HDEmerald/waveform_viewer/README.md

# waveform_viewer
A guitar pedal whose sole purpose is to display the guitar's signal onto a display.
