HDEmerald/waveform_viewer/models/pedal_spacer v4.3mf

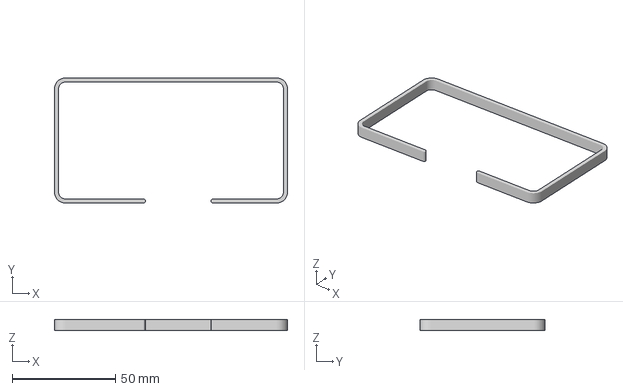
[picture p1: CAD file, 2024-09-13]
models/pedal_spacer v4.3mf
112.8 x 60.5 x 5.50 mm
