HDEmerald/waveform_viewer/models/pedal_spacer v1.3mf

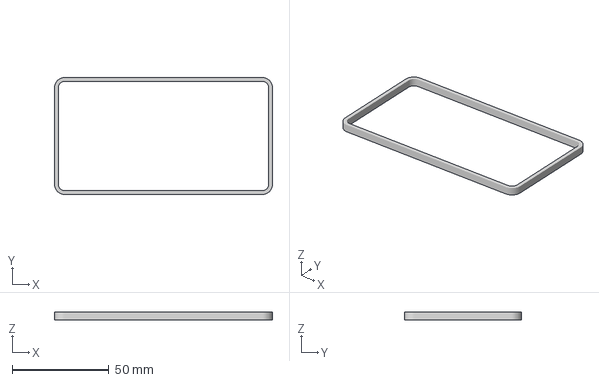
[picture p2: CAD file, 2024-09-13, an earlier design]
models/pedal_spacer v1.3mf
112.8 x 60.5 x 4.00 mm
