HDEmerald/waveform_viewer/models/pedal_spacer v3.3mf

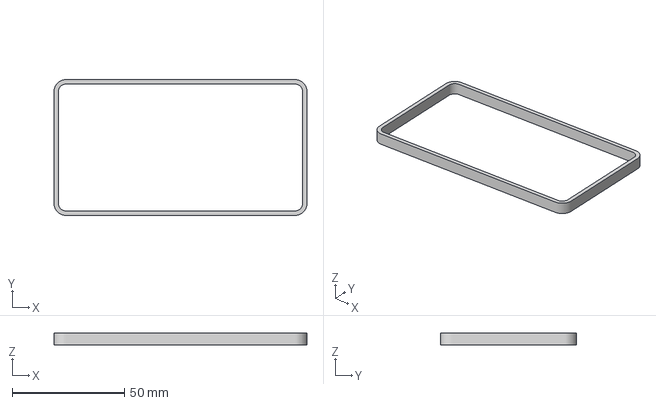
[picture p3: CAD file, 2024-09-13, an earlier design]
models/pedal_spacer v3.3mf
112.8 x 60.5 x 5.50 mm
