HDEmerald/waveform_viewer/models/pedal_spacer v2.3mf

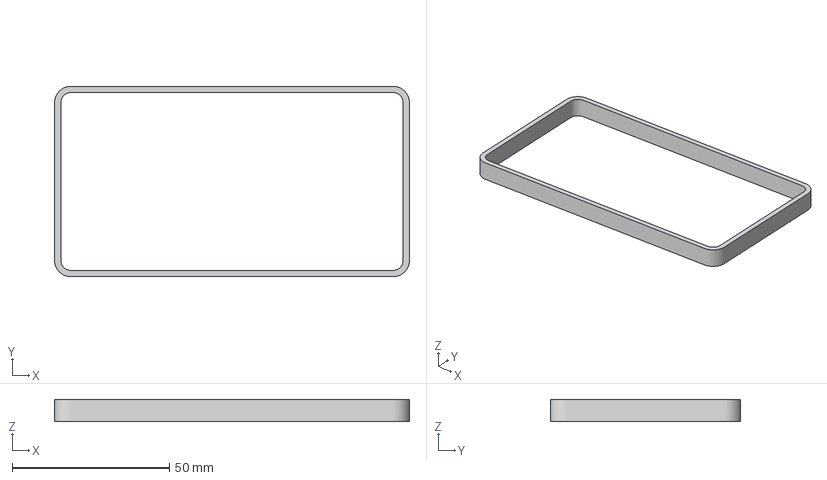
[picture p4: CAD file, 2024-09-13, an earlier design]
models/pedal_spacer v2.3mf
112.8 x 60.5 x 7.00 mm
