HDEmerald/waveform_viewer/sim/guitar_waveform_clamp_sim.asc

D1: diode; 1N4148
Q1: npn; 2N3904
Q2: pnp; 2N3906
R1: res; 1k
R2: res; 8.2k
R3: res; 100k
V1: voltage; 3.3
V2: voltage; 1
Named nets: 0, Vout, Vin
.dc V2 -1 5 .1
Hunter Drake
OLED Guitar Pedal Project (clamp stage)
7/9/2024
 
Creates a 3.3V ADC friendly signal at Vout.
Vin should not go below -0.5V or above 4V to be safe
 
NEEDS TO BE TEST IRL PLEASE TEST MF
