HDEmerald/waveform_viewer/pcb/Guitar_waveform_proj.kicad_pcb

## KiCad design pcb/Guitar_waveform_proj.kicad_pcb (2024-09-13)

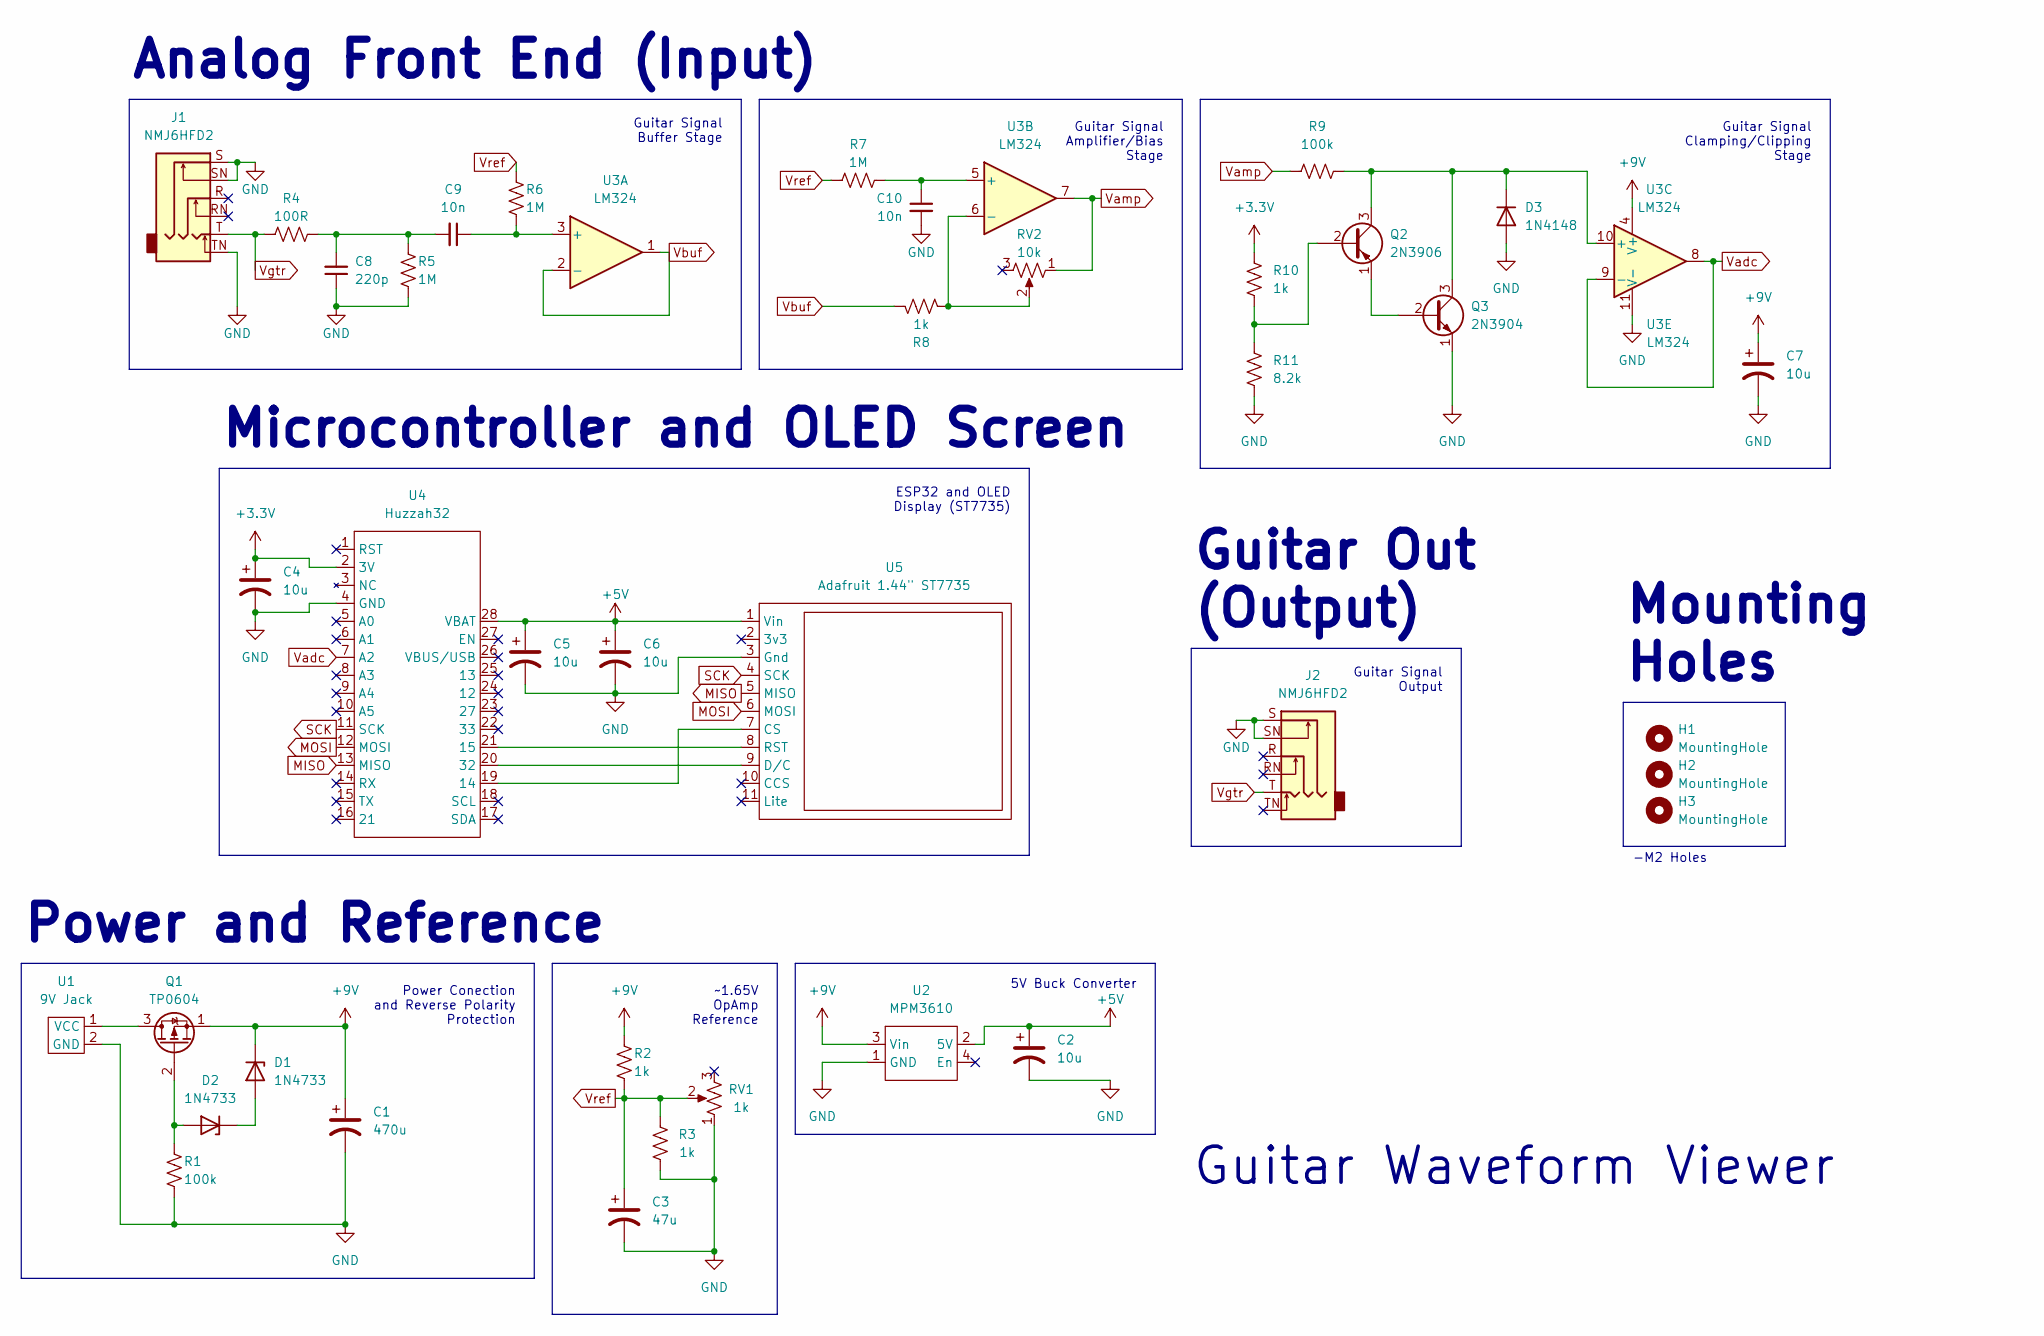
[picture p5: schematic Guitar_waveform_proj.kicad_sch, Guitar Waveform Project]

Parts:
C1: 470u; CP_Radial_D8.0mm_P3.50mm
C2, C4, C5, C6, C7: 10u; CP_Radial_D4.0mm_P1.50mm
C3: 47u; CP_Radial_D5.0mm_P2.00mm
C8: 220p; C_Disc_D5.1mm_W3.2mm_P5.00mm
C9, C10: 10n; C_Disc_D5.1mm_W3.2mm_P5.00mm
D1, D2: 1N4733; D_DO-41_SOD81_P7.62mm_Horizontal
D3: 1N4148; D_DO-35_SOD27_P7.62mm_Horizontal
H1, H2, H3: MountingHole; MountingHole_2.2mm_M2
J1, J2: NMJ6HFD2; My Guitar Jack
Q1: TP0604; TO-92_Inline_Wide
Q2: 2N3906; TO-92_Inline_Wide
Q3: 2N3904; TO-92_Inline_Wide
R1, R9: 100k; R_Axial_DIN0207_L6.3mm_D2.5mm_P10.16mm_Horizontal
R2, R3, R8, R10: 1k; R_Axial_DIN0207_L6.3mm_D2.5mm_P10.16mm_Horizontal
R4: 100R; R_Axial_DIN0207_L6.3mm_D2.5mm_P10.16mm_Horizontal
R5, R6, R7: 1M; R_Axial_DIN0207_L6.3mm_D2.5mm_P10.16mm_Horizontal
R11: 8.2k; R_Axial_DIN0207_L6.3mm_D2.5mm_P10.16mm_Horizontal
RV1: 1k; PinHeader_1x03_P2.54mm_Vertical
RV2: 10k; PinHeader_1x03_P2.54mm_Vertical
U1: 9V Jack; PinHeader_1x02_P2.54mm_Vertical
U2: MPM3610; PinHeader_1x04_P2.54mm_Vertical
U3: LM324; DIP-14_W7.62mm_LongPads
U4: Huzzah32; Adafruit_Huzzah32
U5: Adafruit 1.44" ST7735; Adafruit_1.44_ST7735

Connections:
+3.3V: C4.1, R10.1, U4.2 (3V)
+5V: C2.1, C5.1, C6.1, U2.2 (5V), U4.28 (VBAT), U5.1 (Vin)
+9V: C1.1, C7.1, D1.1 (K), Q1.1 (S), R2.1, U2.3 (Vin), U3.4 (V+)
GND: C1.2, C2.2, C3.2, C4.2, C5.2, C6.2, C7.2, C8.1, C10.2, D3.2 (A), J1.S, J1.SN, J1.TN, J2.S, J2.SN, Q3.1 (E), R1.2, R3.2, R5.2, R11.2, RV1.1, U1.2 (GND), U2.1 (GND), U3.11 (V-), U4.4 (GND), U5.3 (Gnd)
MISO: U4.13 (MISO), U5.5 (MISO)
MOSI: U4.12 (MOSI), U5.6 (MOSI)
unnamed: C8.2, C9.2, R4.1, R5.1
unnamed: D1.2 (A), D2.1 (K)
unnamed: D2.2 (A), Q1.2 (G), R1.1
unnamed: D3.1 (K), Q2.3 (C), Q3.3 (C), R9.1, U3.10 (+)
unnamed: Q1.3 (D), U1.1 (VCC)
unnamed: Q2.2 (B), R10.2, R11.1
unnamed: Q2.1 (E), Q3.2 (B)
unnamed: C9.1, R6.2, U3.3 (+)
unnamed: C10.1, R7.1, U3.5 (+)
unnamed: R8.1, RV2.2, U3.6 (-)
unnamed: U4.19 (14), U5.7 (CS)
unnamed: U4.21 (15), U5.8 (RST)
unnamed: U4.20 (32), U5.9 (D/C)
SCK: U4.11 (SCK), U5.4 (SCK)
Vadc: U3.8, U3.9 (-), U4.7 (A2)
Vamp: R9.2, RV2.1, U3.7
Vbuf: R8.2, U3.1, U3.2 (-)
Vgtr: J1.T, J2.T, R4.2
Vref: C3.1, R2.2, R3.1, R6.1, R7.2, RV1.2

Notes on the sheet:
Mounting Holes
Microcontroller and OLED Screen
-M2 Holes
Power and Reference
Guitar Signal Amplifier/Bias Stage
Guitar Waveform Viewer
Guitar Signal Output
5V Buck Converter
Guitar Signal Clamping/Clipping Stage
Analog Front End (Input)
Guitar Signal Buffer Stage
Guitar Out (Output)
~1.65V OpAmp Reference
ESP32 and OLED Display (ST7735)
Power Conection and Reverse Polarity Protection

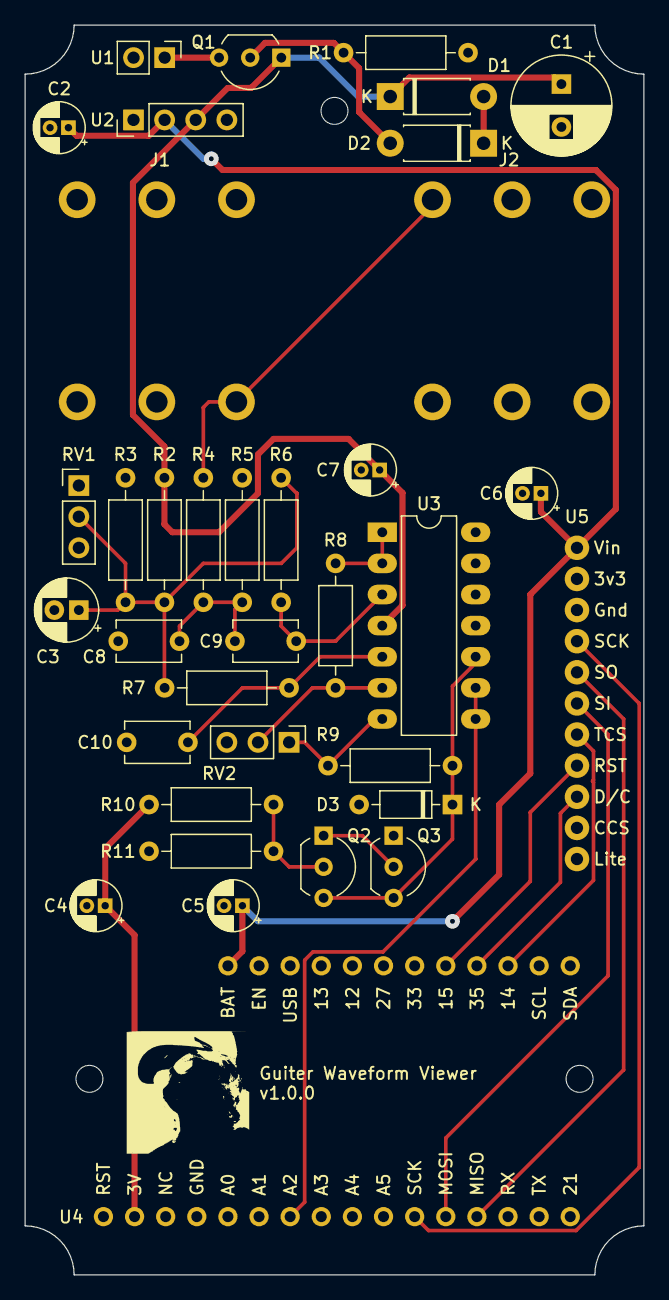
[picture p6: board Guitar_waveform_proj.kicad_pcb from above]

Board: 2 copper layers, 50.5 x 102.0 mm, 39 parts (0 on the bottom side), 25 nets.
