HDEmerald/waveform_viewer/(commit log)

2024-09-06 First complete version
    [Guitar_waveform_proj-B_Cu.gbl, Guitar_waveform_proj-B_Cu.gbr, Guitar_waveform_proj-B_Mask.gbr, Guitar_waveform_proj-B_Mask.gbs, Guitar_waveform_proj-B_Paste.gbp, Guitar_waveform_proj-B_Paste.gbr, Guitar_waveform_proj-B_Silkscreen.gbo, Guitar_waveform_proj-B_Silkscreen.gbr]
2024-09-13 Adding spacer models files
    [pedal_spacer v1.3mf, pedal_spacer v2.3mf, pedal_spacer v3.3mf, pedal_spacer v4.3mf]
2024-09-13 Added final details about v1.0.0
    Updated the notes,
    updated the pcb files somewhere I think? Nothing major, just touch ups
    [Guitar_waveform_proj.kicad_pcb]
